Punit899/can-parking-assist/docs/wiring_reference.pdf

# CAN Parking Assist: Wiring Reference

Sensor node (STM32F407G-DISC1) + HMI node (NUCLEO-F103RB) on one breadboard, connected over CAN at 500 kbit/s

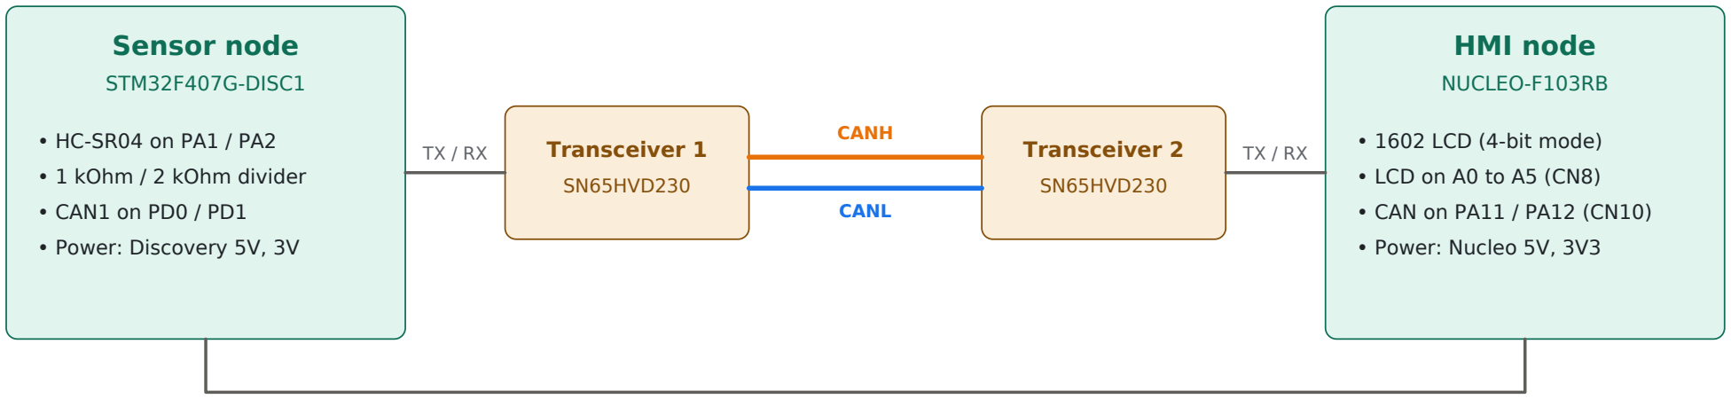
[picture p3: figure]
Sensor node; STM32F407G-DISC1; • 1 kOhm / 2 kOhm divider; • CAN1 on PD0 / PD1; • Power: Discovery 5V, 3V; Transceiver 1; SN65HVD230; Transceiver 2; HMI node; NUCLEO-F103RB; • 1602 LCD (4-bit mode); • LCD on A0 to A5 (CN8); • CAN on PA11 / PA12 (CN10); • Power: Nucleo 5V, 3V3; CANH; CANL

CAN Parking Assist | Wiring reference | github.com/Punit899/can-parking-assist | Page 1

Common GND wire between the boards (only GND, never 5V)

## Rules that prevent most faults

### 1. Wire with both boards unplugged. Plug in one board at a time and check it

before adding the next.

### 2. Never connect the 5V of the two boards together. Each board is powered

from its own USB cable.

3. Transceivers run on 3.3 V (3V / 3V3 pin), never 5 V.

### 4. CAN TX goes to CAN TX and RX to RX. A CAN transceiver does not cross

them like UART.

### 5. Every part sits with each pin in its own numbered breadboard column. A part

turned 90 degrees shorts its pins.

### 6. Bus rails on large breadboards can be split in the middle. Bridge both halves

or keep a node on one half.

### 7. The HC-SR04 echo is 5 V: it must reach PA1 only through the 1 kOhm / 2

kOhm divider.

## Suggested breadboard layout (large Wanjie board)

Area | Use
Bus strip A (top) | Discovery 5V (+) and GND (-)
Terminal strip 1 | HC-SR04, divider, transceiver 1
Bus strip B | leave empty (separates the two supplies)
Terminal strip 2 | 1602 LCD, transceiver 2
Bus strip C | Nucleo 5V (+) and GND (-)
Strips 3 / 4, D / E | free (buzzer, LEDs later)

In every bus strip: upper row = +5V, lower row = GND. Mark the ends with tape.

# 1 Sensor node: HC-SR04 ultrasonic sensor

STM32F407G-DISC1 | Trig on PA2 (TIM2_CH3) | Echo on PA1 (TIM2_CH2) through a 5 V to 3.3 V divider

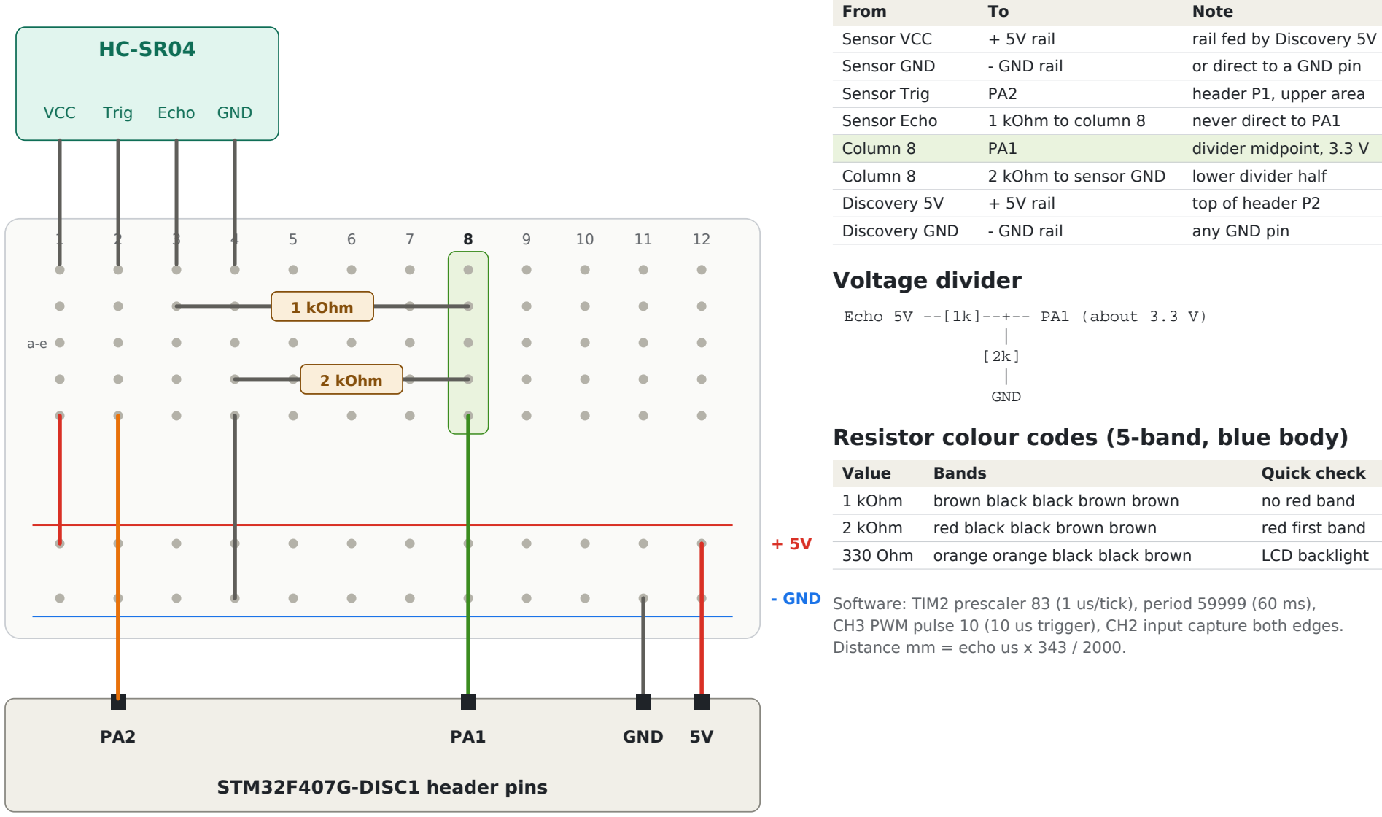
[picture p4: figure]
- GND; VCC; Trig; Echo; GND; 1 kOhm; 2 kOhm; STM32F407G-DISC1 header pins; From; Note; Sensor VCC; + 5V rail; rail fed by Discovery 5V; Sensor Trig; header P1, upper area; Sensor Echo; 1 kOhm to column 8; never direct to PA1; Column 8; divider midpoint, 3.3 V; 2 kOhm to sensor GND; lower divider half; Discovery 5V; top of header P2; Discovery GND; - GND rail; any GND pin; Voltage divider; Echo 5V --[1k]--+-- PA1 (about 3.3 V) | [2k] | GND; Value; Bands; Quick check; brown black black brown brown; no red band; red black black brown brown; red first band; 330 Ohm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

CAN Parking Assist | Wiring reference | github.com/Punit899/can-parking-assist | Page 2

Column 8 (green) holds exactly three things: the 1 kOhm leg, the 2 kOhm leg and the PA1 wire.

## Connections

Sensor GND | - GND rail | or direct to a GND pin

## Resistor colour codes (5-band, blue body)

Software: TIM2 prescaler 83 (1 us/tick), period 59999 (60 ms), CH3 PWM pulse 10 (10 us trigger), CH2 input capture both edges.

# 2 HMI node: 1602 LCD (HD44780, 4-bit mode)

## Parking Assist

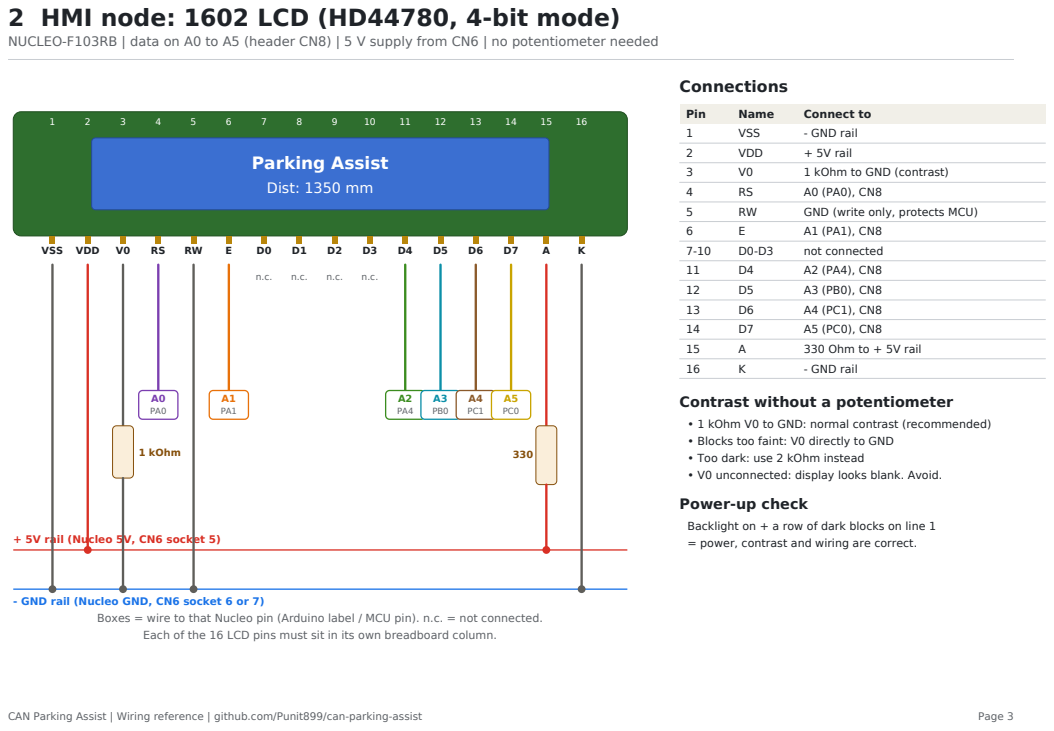
[picture p5: page 3]

NUCLEO-F103RB | data on A0 to A5 (header CN8) | 5 V supply from CN6 | no potentiometer needed

• 1 kOhm V0 to GND: normal contrast (recommended)
• Blocks too faint: V0 directly to GND
• Too dark: use 2 kOhm instead
• V0 unconnected: display looks blank. Avoid.

Backlight on + a row of dark blocks on line 1
= power, contrast and wiring are correct.

- GND rail (Nucleo GND, CN6 socket 6 or 7)

Boxes = wire to that Nucleo pin (Arduino label / MCU pin). n.c. = not connected.

Each of the 16 LCD pins must sit in its own breadboard column.

# 3 CAN transceivers and bus, and how to bring it up

One SN65HVD230 module per node | 500 kbit/s | 120 Ohm termination on each module (60 Ohm across the bus)
CAN Parking Assist | Wiring reference | github.com/Punit899/can-parking-assist | Page 4

## Transceiver modules

Module pin | Sensor node (STM32F407) HMI node (STM32F103)
3.3V | 3V pin (P2, top) | 3V3 (CN6, socket 4)
GND | GND | GND
CAN TX | PD1 (P2, lower half) | PA12: CN10 outer row, level with SCK/D13
CAN RX | PD0 (P2, lower half) | PA11: CN10 outer row, level with MISO/D12

## Bus between the nodes

From | To | Note
Module 1 CANH | Module 2 CANH | twist with the CANL wire
Module 1 CANL | Module 2 CANL | 2-pin header next to terminal
Discovery GND | Nucleo GND | common ground; never connect the 5V pins

## Logic analyser (only when measuring)

Analyser | Connect to | Shows
GND | Discovery GND | reference, always needed
CH1 | PD0 | whole bus traffic incl. ACK bit
CH2 | PD1 | sensor node's own frames

## Bring-up in stages

### 1 Sensor node only

Plug in the Discovery. Console shows distances, st=0.

### 2 Add the HMI node

Plug in the Nucleo. LCD shows 'Parking Assist'.

### 3 Bus

Discovery green LED on, Nucleo LED blinks, live distance.

## If the bus does not work: read the Discovery LEDs

LEDs | Meaning | Check
Green | bus OK | nothing to do
Red + blue | no acknowledgement | HMI side: PA11/12, 3V3, bus
Red only | sensor cannot see bus own module: PD0/PD1, 3V
