Punit899/can-parking-assist/hmi_node/Core/Src/main.c

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
/* Includes ------------------------------------------------------------------*/
#include "main.h"

/* USER CODE BEGIN Includes */
#include <stdio.h>
#include "lcd1602.h"
/* USER CODE END Includes */

/* USER CODE BEGIN PTD */
typedef enum {
  ZONE_CLEAR = 0,
  ZONE_CAUTION,
  ZONE_WARNING,
  ZONE_DANGER,
  ZONE_STOP,
  ZONE_NO_ECHO,
  ZONE_SENSOR_LOST,
  ZONE_COUNT
} Zone_t;
/* USER CODE END PTD */

/* USER CODE BEGIN PD */
#define CAN_ID_PA_DISTANCE   0x200
#define CAN_DLC_PA_DISTANCE  4
#define ZONE_STOP_MM      50
#define ZONE_DANGER_MM    150
#define ZONE_WARNING_MM   300
#define ZONE_CAUTION_MM   500
#define RX_TIMEOUT_MS     300
/* USER CODE END PD */

CAN_HandleTypeDef hcan;

UART_HandleTypeDef huart2;

/* USER CODE BEGIN PV */
CAN_TxHeaderTypeDef txHeader;
CAN_RxHeaderTypeDef rxHeader;
uint8_t  txData[8];
uint8_t  rxData[8];
uint32_t txMailbox;
uint8_t  aliveCounter = 0;
uint16_t simDistMm = 2000;
volatile uint16_t rxDistMm = 0;
volatile uint8_t  rxStatus = 0;
volatile uint8_t  rxAlive = 0;
volatile uint32_t rxCount = 0;
volatile uint32_t lastRxTick = 0;
uint32_t lastLcdTick = 0;
Zone_t   lastZone = ZONE_COUNT;   /* forces the first LCD update */
/* USER CODE END PV */

void SystemClock_Config(void);
static void MX_GPIO_Init(void);
static void MX_CAN_Init(void);
static void MX_USART2_UART_Init(void);
/* USER CODE BEGIN 0 */
int _write(int file, char *ptr, int len)
{
  for (int i = 0; i < len; i++)
  {
    ITM_SendChar(ptr[i]);
  }
  return len;
}

typedef struct { uint16_t onMs; uint16_t periodMs; } BlinkPattern_t;

/* periodMs = 0 means constant: onMs != 0 is on, 0 is off */
static const BlinkPattern_t blinkTable[ZONE_COUNT] = {
  [ZONE_CLEAR]       = {   0,    0 },
  [ZONE_CAUTION]     = { 100,  800 },
  [ZONE_WARNING]     = { 100,  300 },
  [ZONE_DANGER]      = {  60,  140 },
  [ZONE_STOP]        = {   1,    0 },
  [ZONE_NO_ECHO]     = {   0,    0 },
  [ZONE_SENSOR_LOST] = {  50, 2000 },
};

static const char *zoneText[ZONE_COUNT] = {
  [ZONE_CLEAR]       = "Path clear      ",
  [ZONE_CAUTION]     = "Caution         ",
  [ZONE_WARNING]     = "Warning: slow   ",
  [ZONE_DANGER]      = "DANGER: brake!  ",
  [ZONE_STOP]        = "STOP!           ",
  [ZONE_NO_ECHO]     = "No echo/range   ",
  [ZONE_SENSOR_LOST] = "Sensor lost!    ",
};

static Zone_t GetZone(uint32_t now)
{
  if ((now - lastRxTick) > RX_TIMEOUT_MS) return ZONE_SENSOR_LOST;
  if (rxStatus != 0)                      return ZONE_NO_ECHO;

  uint16_t d = rxDistMm;
  if (d <= ZONE_STOP_MM)    return ZONE_STOP;
  if (d <= ZONE_DANGER_MM)  return ZONE_DANGER;
  if (d <= ZONE_WARNING_MM) return ZONE_WARNING;
  if (d <= ZONE_CAUTION_MM) return ZONE_CAUTION;
  return ZONE_CLEAR;
}

static void WarningLed_Update(Zone_t z, uint32_t now)
{
  const BlinkPattern_t *p = &blinkTable[z];
  GPIO_PinState on;

  if (p->periodMs == 0)
    on = (p->onMs != 0) ? GPIO_PIN_SET : GPIO_PIN_RESET;
  else
    on = ((now % p->periodMs) < p->onMs) ? GPIO_PIN_SET : GPIO_PIN_RESET;

  HAL_GPIO_WritePin(LD2_GPIO_Port, LD2_Pin, on);
}
/* USER CODE END 0 */

/**
  * @brief  The application entry point.
  * @retval int
  */
int main(void)
{

  /* MCU Configuration--------------------------------------------------------*/

  /* Reset of all peripherals, Initializes the Flash interface and the Systick. */
  HAL_Init();

  /* Configure the system clock */
  SystemClock_Config();

  /* Initialize all configured peripherals */
  MX_GPIO_Init();
  MX_CAN_Init();
  MX_USART2_UART_Init();
  /* USER CODE BEGIN 2 */
  CAN_FilterTypeDef filter = {0};
  filter.FilterBank = 0;
  filter.FilterMode = CAN_FILTERMODE_IDMASK;
  filter.FilterScale = CAN_FILTERSCALE_32BIT;
  filter.FilterFIFOAssignment = CAN_RX_FIFO0;
  filter.FilterActivation = ENABLE;

  if (HAL_CAN_ConfigFilter(&hcan, &filter) != HAL_OK) Error_Handler();
  if (HAL_CAN_Start(&hcan) != HAL_OK) Error_Handler();
  if (HAL_CAN_ActivateNotification(&hcan, CAN_IT_RX_FIFO0_MSG_PENDING) != HAL_OK) Error_Handler();

  txHeader.StdId = CAN_ID_PA_DISTANCE;
  txHeader.IDE   = CAN_ID_STD;
  txHeader.RTR   = CAN_RTR_DATA;
  txHeader.DLC   = CAN_DLC_PA_DISTANCE;
  LCD_Init();
  LCD_SetCursor(0, 0);
  LCD_Print("Parking Assist");
  HAL_Delay(1000);              /* short splash screen */
  /* USER CODE END 2 */

  /* Infinite loop */
  /* USER CODE BEGIN WHILE */
  while (1)
  {
    /* USER CODE END WHILE */

	    /* USER CODE BEGIN 3 */
	    uint32_t now = HAL_GetTick();
	    Zone_t zone = GetZone(now);

	    WarningLed_Update(zone, now);   /* runs every loop pass, no blocking delay */

	    if ((now - lastLcdTick) >= 100)
	    {
	      lastLcdTick = now;

	      if (zone != lastZone)         /* redraw the message only when the zone changes */
	      {
	        LCD_SetCursor(0, 0);
	        LCD_Print(zoneText[zone]);
	        lastZone = zone;
	      }

	      char line[17];
	      if (zone == ZONE_NO_ECHO || zone == ZONE_SENSOR_LOST)
	      {
	        snprintf(line, sizeof(line), "Dist:   -- mm   ");
	      }
	      else
	      {
	        unsigned int d = rxDistMm;
	        if (d > 9999) d = 9999;
	        snprintf(line, sizeof(line), "Dist: %4u mm   ", d);
	      }
	      LCD_SetCursor(1, 0);
	      LCD_Print(line);

	      printf("dist=%u st=%u alive=%u zone=%u\r\n",
	             rxDistMm, rxStatus, rxAlive, (unsigned)zone);
	    }
	  }
  /* USER CODE END 3 */
}

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
/* USER CODE BEGIN 4 */
void HAL_CAN_RxFifo0MsgPendingCallback(CAN_HandleTypeDef *hcan)
{
  if (HAL_CAN_GetRxMessage(hcan, CAN_RX_FIFO0, &rxHeader, rxData) == HAL_OK)
  {
    if (rxHeader.StdId == CAN_ID_PA_DISTANCE && rxHeader.DLC == CAN_DLC_PA_DISTANCE)
    {
      rxDistMm = rxData[0] | (rxData[1] << 8);
      rxStatus = rxData[2];
      rxAlive  = rxData[3];
      rxCount++;
      lastRxTick = HAL_GetTick();
    }
  }
}
/* USER CODE END 4 */
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
