Punit899/can-parking-assist/sensor_node/Core/Src/main.c

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
/* Includes ------------------------------------------------------------------*/
#include "main.h"
#include "usb_host.h"

/* USER CODE BEGIN Includes */
#include <stdio.h>
/* USER CODE END Includes */

/* USER CODE BEGIN PD */
#define CAN_ID_PA_DISTANCE   0x200
#define CAN_DLC_PA_DISTANCE  4
/* USER CODE END PD */

CAN_HandleTypeDef hcan1;

I2C_HandleTypeDef hi2c1;

I2S_HandleTypeDef hi2s3;

SPI_HandleTypeDef hspi1;

TIM_HandleTypeDef htim2;

/* USER CODE BEGIN PV */
CAN_TxHeaderTypeDef txHeader;
CAN_RxHeaderTypeDef rxHeader;
uint8_t  txData[8];
uint8_t  rxData[8];
uint32_t txMailbox;
volatile uint32_t rxCount = 0;
volatile uint32_t echoRise = 0;
volatile uint32_t echoWidthUs = 0;
volatile uint8_t  newMeasurement = 0;
uint8_t aliveCounter = 0;
volatile uint16_t rxDistMm = 0;
volatile uint8_t  rxStatus = 0;
volatile uint8_t  rxAlive = 0;
/* USER CODE END PV */

void SystemClock_Config(void);
static void MX_GPIO_Init(void);
static void MX_CAN1_Init(void);
static void MX_I2C1_Init(void);
static void MX_I2S3_Init(void);
static void MX_SPI1_Init(void);
static void MX_TIM2_Init(void);
void MX_USB_HOST_Process(void);

/* USER CODE BEGIN 0 */
int _write(int file, char *ptr, int len)
{
  for (int i = 0; i < len; i++)
  {
    ITM_SendChar(ptr[i]);
  }
  return len;
}
/* USER CODE END 0 */

/**
  * @brief  The application entry point.
  * @retval int
  */
int main(void)
{

  /* MCU Configuration--------------------------------------------------------*/

  /* Reset of all peripherals, Initializes the Flash interface and the Systick. */
  HAL_Init();

  /* Configure the system clock */
  SystemClock_Config();

  /* Initialize all configured peripherals */
  MX_GPIO_Init();
  MX_CAN1_Init();
  MX_I2C1_Init();
  MX_I2S3_Init();
  MX_SPI1_Init();
  MX_USB_HOST_Init();
  MX_TIM2_Init();
  /* USER CODE BEGIN 2 */
  CAN_FilterTypeDef filter = {0};
  filter.FilterBank = 0;
  filter.FilterMode = CAN_FILTERMODE_IDMASK;
  filter.FilterScale = CAN_FILTERSCALE_32BIT;
  filter.FilterFIFOAssignment = CAN_RX_FIFO0;   /* mask 0 = accept all IDs */
  filter.FilterActivation = ENABLE;
  filter.SlaveStartFilterBank = 14;

  if (HAL_CAN_ConfigFilter(&hcan1, &filter) != HAL_OK) Error_Handler();
  if (HAL_CAN_Start(&hcan1) != HAL_OK) Error_Handler();
  if (HAL_CAN_ActivateNotification(&hcan1, CAN_IT_RX_FIFO0_MSG_PENDING) != HAL_OK) Error_Handler();

  txHeader.StdId = CAN_ID_PA_DISTANCE;
  txHeader.IDE   = CAN_ID_STD;
  txHeader.RTR   = CAN_RTR_DATA;
  txHeader.DLC   = CAN_DLC_PA_DISTANCE;
  HAL_TIM_IC_Start_IT(&htim2, TIM_CHANNEL_2);
  HAL_TIM_PWM_Start(&htim2, TIM_CHANNEL_3);
  /* USER CODE END 2 */

  /* Infinite loop */
  /* USER CODE BEGIN WHILE */
  while (1)
  {
    /* USER CODE END WHILE */
    MX_USB_HOST_Process();

    /* USER CODE BEGIN 3 */
    uint32_t width = echoWidthUs;
        uint16_t distMm = (uint16_t)(width * 343 / 2000);
        uint8_t  status = (width == 0 || width > 25000) ? 1 : 0;

        txData[0] = distMm & 0xFF;
        txData[1] = distMm >> 8;
        txData[2] = status;
        txData[3] = aliveCounter++;
        HAL_CAN_AddTxMessage(&hcan1, &txHeader, txData, &txMailbox);

        HAL_Delay(100);

        uint32_t esr = hcan1.Instance->ESR;
           uint8_t  lec = (esr >> 4) & 0x7;     /* last error code */
           uint8_t  tec = (esr >> 16) & 0xFF;   /* transmit error counter */

           HAL_GPIO_WritePin(GPIOD, GPIO_PIN_12, (tec == 0) ? GPIO_PIN_SET : GPIO_PIN_RESET); /* green: bus OK */
           HAL_GPIO_WritePin(GPIOD, GPIO_PIN_14, (tec > 0)  ? GPIO_PIN_SET : GPIO_PIN_RESET); /* red: transmit errors */
           HAL_GPIO_WritePin(GPIOD, GPIO_PIN_15, (lec == 3) ? GPIO_PIN_SET : GPIO_PIN_RESET); /* blue: no acknowledgement */

           printf("TX dist=%u alive=%u | TEC=%u LEC=%u\r\n", distMm, txData[3], tec, lec);
      }
  /* USER CODE END 3 */
}

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
/* USER CODE BEGIN 4 */
void HAL_CAN_RxFifo0MsgPendingCallback(CAN_HandleTypeDef *hcan)
{
	if (HAL_CAN_GetRxMessage(hcan, CAN_RX_FIFO0, &rxHeader, rxData) == HAL_OK)
	{
		if (rxHeader.StdId == CAN_ID_PA_DISTANCE && rxHeader.DLC == CAN_DLC_PA_DISTANCE)
		{
			rxDistMm = rxData[0] | (rxData[1] << 8);
			rxStatus = rxData[2];
			rxAlive  = rxData[3];
			rxCount++;
			HAL_GPIO_TogglePin(GPIOD, GPIO_PIN_13);
		}
	}
}

void HAL_TIM_IC_CaptureCallback(TIM_HandleTypeDef *htim)
{
  if (htim->Instance == TIM2 && htim->Channel == HAL_TIM_ACTIVE_CHANNEL_2)
  {
    uint32_t t = HAL_TIM_ReadCapturedValue(htim, TIM_CHANNEL_2);

    if (HAL_GPIO_ReadPin(GPIOA, GPIO_PIN_1) == GPIO_PIN_SET)
    {
      echoRise = t;
    }
    else
    {
      uint32_t period = __HAL_TIM_GET_AUTORELOAD(htim) + 1;
      echoWidthUs = (t + period - echoRise) % period;
      newMeasurement = 1;
    }
  }
}
/* USER CODE END 4 */
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
