Punit899/can-parking-assist/(commit log)

2026-10-11 Sensor node: CAN1 loopback at 500 kbit/s working
2026-10-12 Add SWO printf output, fix CAN start timeout with pull-up on floating RX pin
2026-10-12 Add HC-SR04 distance measurement with TIM2 PWM trigger and input capture
2026-10-12 Update README: distance measurement done, add hardware and pin assignment
2026-10-14 HMI node: add HD44780 4-bit LCD driver, show received distance
2026-10-15 Two-node CAN bus over SN65HVD230: sensor node sends PA_Distance, HMI node shows it on LCD; ESR-based bus diagnostics on sensor LEDs
2026-10-16 HMI node: distance zones with LCD warning messages, LED blink patterns and CAN timeout
2026-10-16 Verify CAN timing with logic analyser: bit time, frame length, cycle time, bus load
2026-10-16 Add raw logic analyser capture and wiring reference PDF
2026-10-16 Add wiring reference PDF
